RobH-WKGS/wireless-prop-trigger/docs/prop_rx_schematic.png

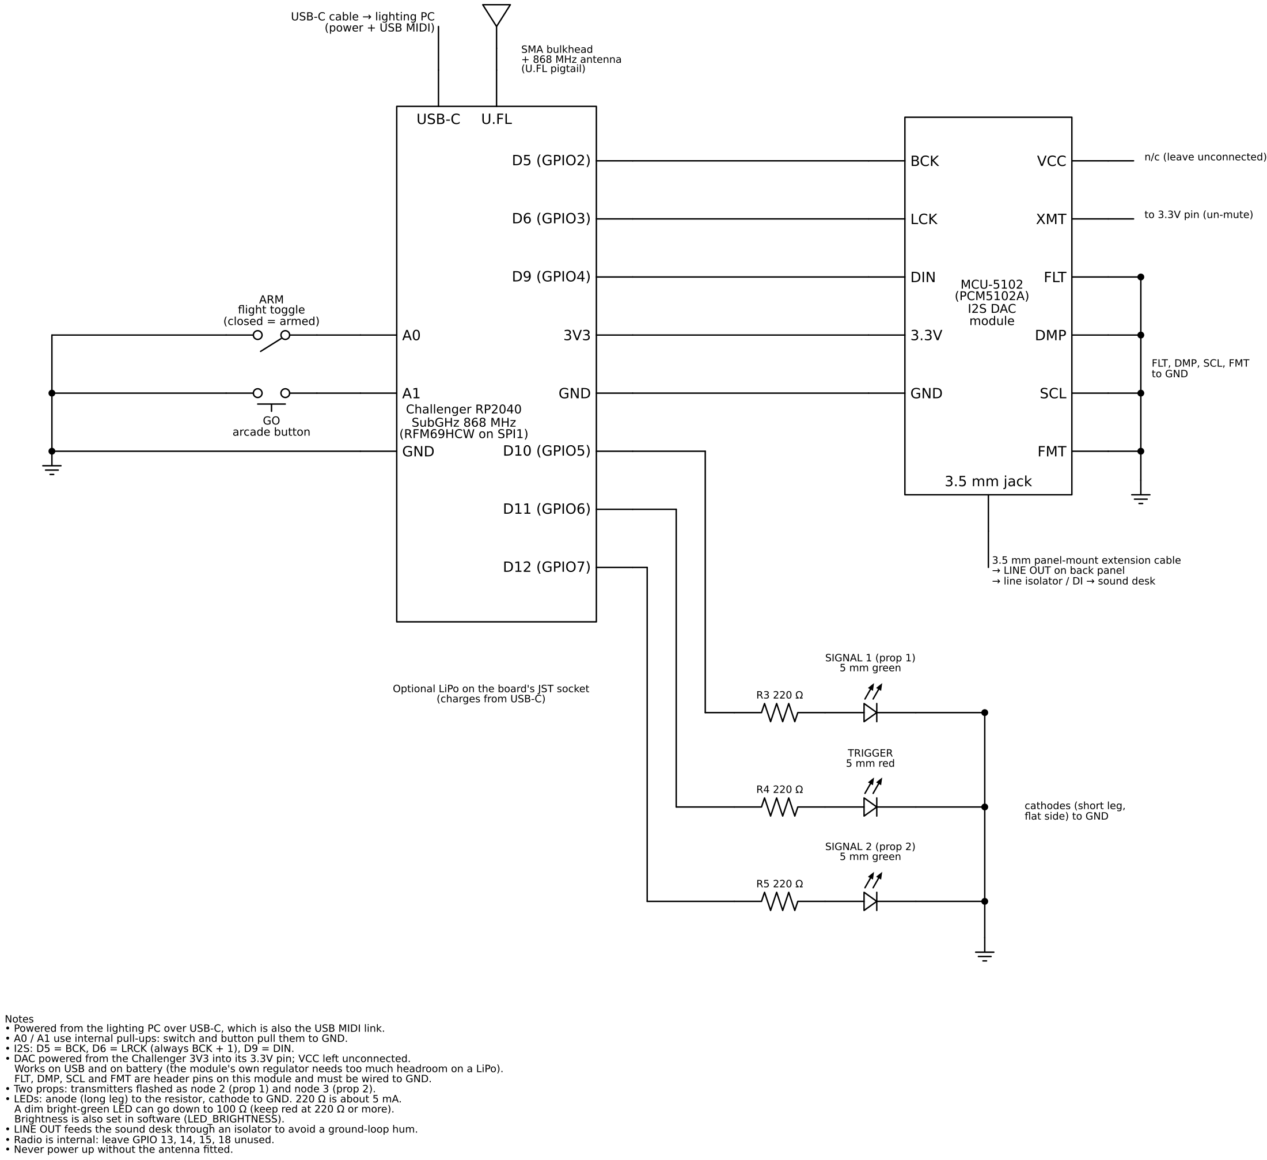
docs/prop_rx_schematic.png
