RobH-WKGS/wireless-prop-trigger/docs/prop_tx_schematic.png

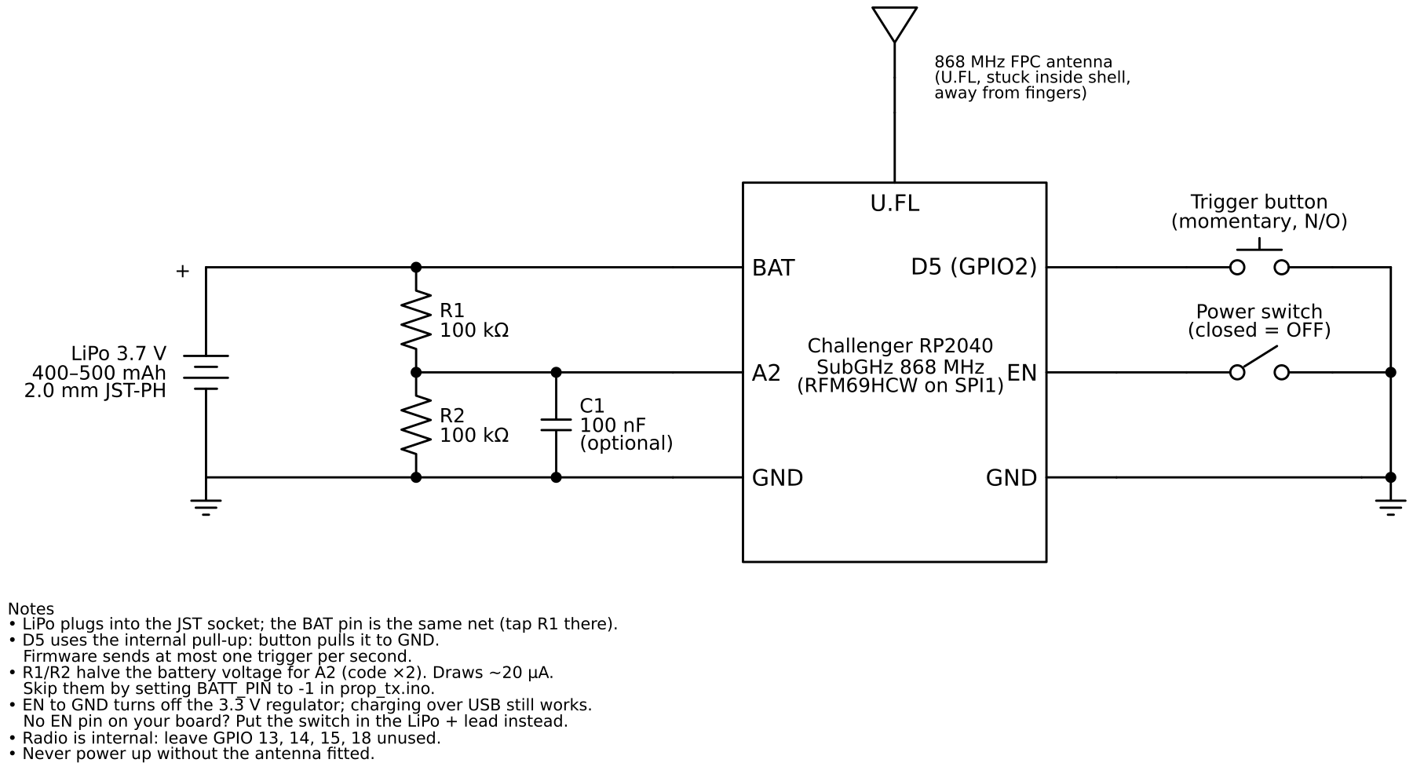
docs/prop_tx_schematic.png
