RobH-WKGS/wireless-prop-trigger/enclosure/3mf/receiver_lid.3mf

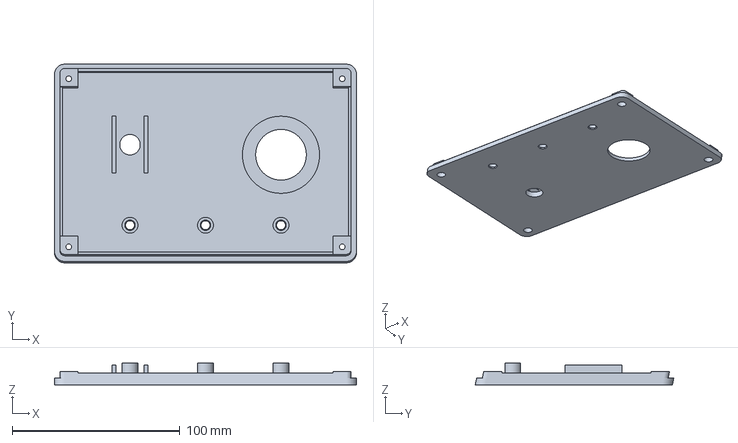
[picture p9: CAD file, 2026-11-09]
enclosure/3mf/receiver_lid.3mf
180.0 x 118.4 x 13.0 mm
