RobH-WKGS/wireless-prop-trigger/enclosure/stl/receiver_fit_panel.stl

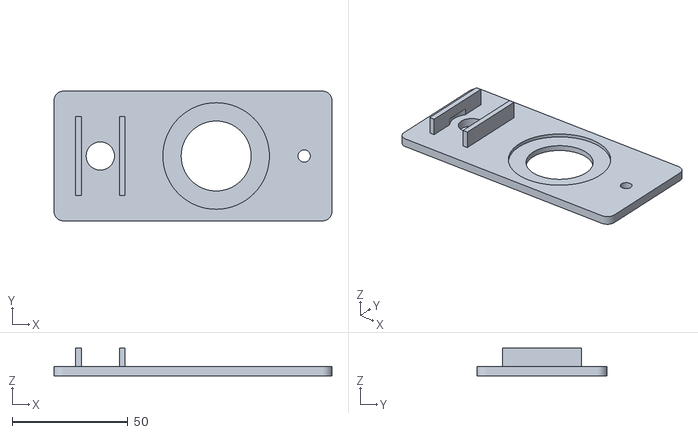
[picture p10: CAD file, 2026-11-09]
enclosure/stl/receiver_fit_panel.stl
120.0 x 56.0 x 12.0
