RobH-WKGS/wireless-prop-trigger/enclosure/3mf/receiver_base.3mf

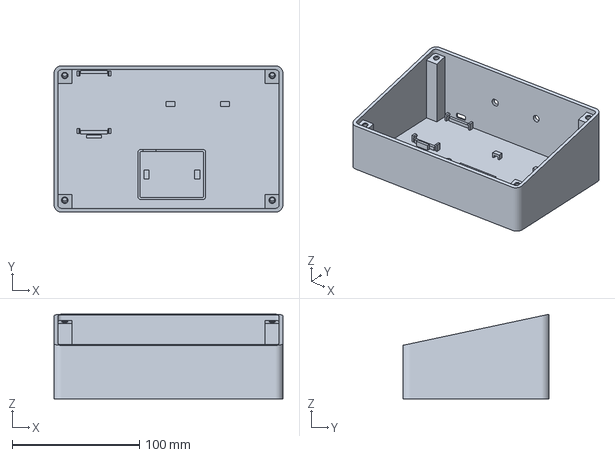
[picture p11: CAD file, 2026-11-06]
enclosure/3mf/receiver_base.3mf
180.0 x 115.0 x 66.4 mm
