RobH-WKGS/wireless-prop-trigger/enclosure/stl/receiver_lid_text.stl

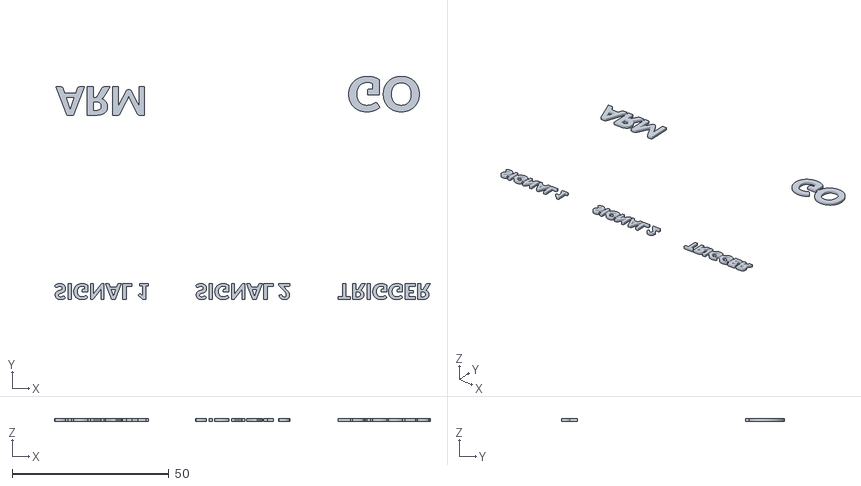
[picture p12: CAD file, 2026-11-09]
enclosure/stl/receiver_lid_text.stl
119.9 x 71.3 x 1.00
