RobH-WKGS/wireless-prop-trigger/enclosure/stl/receiver_base_text.stl

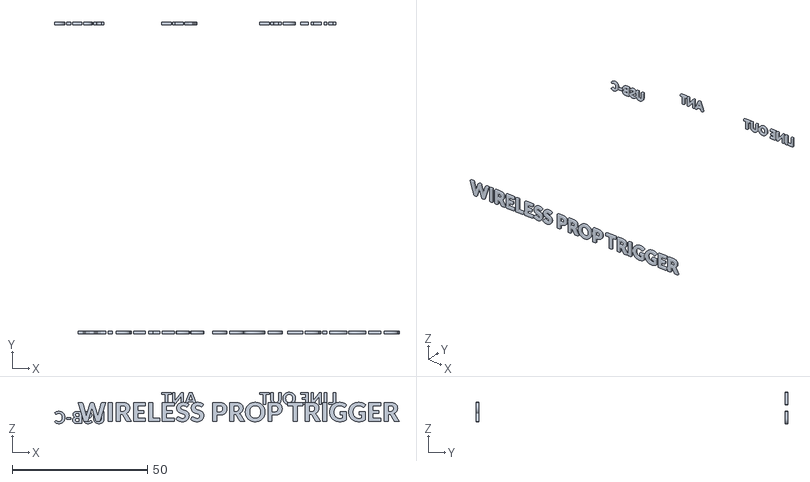
[picture p13: CAD file, 2026-10-31]
enclosure/stl/receiver_base_text.stl
127.3 x 115.0 x 11.7
