RobH-WKGS/wireless-prop-trigger/enclosure/stl/receiver_fit_cradle.stl

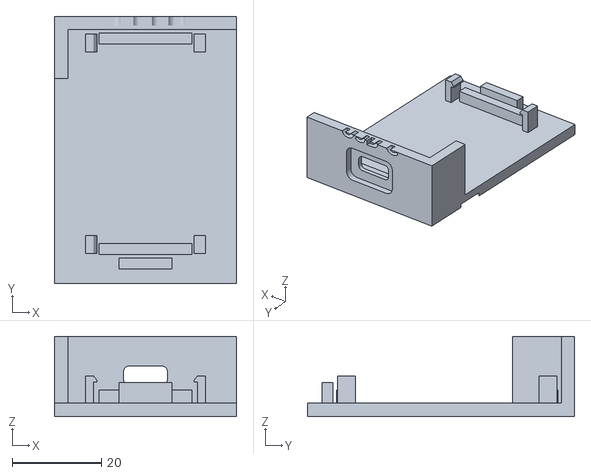
[picture p14: CAD file, 2026-10-31]
enclosure/stl/receiver_fit_cradle.stl
40.9 x 60.0 x 18.0
