RobH-WKGS/wireless-prop-trigger/(list of files, cad)

Other CAD files:
enclosure/stl/receiver_base.stl
enclosure/stl/receiver_lid.stl
