RobH-WKGS/wireless-prop-trigger/enclosure/images/lid_print_face.png

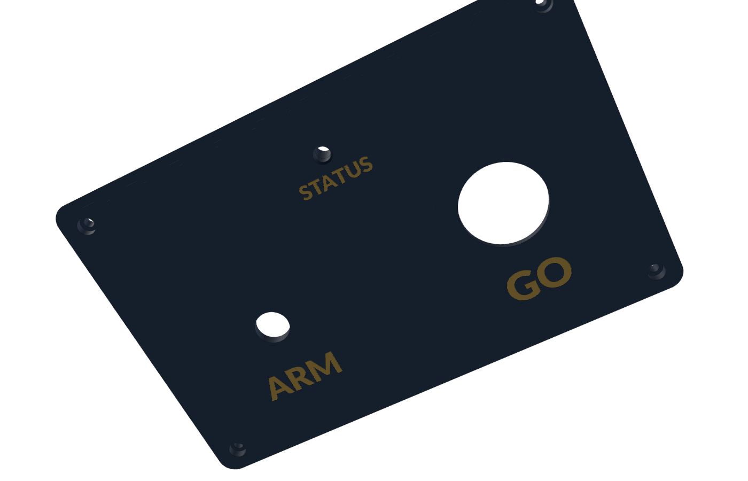
enclosure/images/lid_print_face.png
