RobH-WKGS/wireless-prop-trigger/(commit log)

2026-10-26 Wireless prop trigger: Challenger RP2040 SubGHz transmitter and receiver
    RFM69 868MHz prop button -> USB MIDI note for Avolites Titan plus
    synced WAV playback over I2S. Includes README with parts list,
    wiring, Titan setup and show-day checklist.
    Claude-Session: https://claude.ai/code/session_01HzwnzX2aJoiBGHMYVSww5y
2026-10-28 Add prop transmitter schematic (SVG/PNG + schemdraw source)
    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
2026-10-31 Add 3D-printable receiver case
    Parametric OpenSCAD desk console: base tray + control lid with flight
    switch (ARM), 30 mm arcade button (GO) and status LED. M3 SHCS into
    heat-set inserts, USB-C/SMA/line-out on the back panel, snap-in board
    cradle, DAC and LiPo mounts, fit-test coupons, print notes and
    previews. README parts list updated to match.
    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
    [receiver_base.stl, receiver_case.scad, receiver_fit_cradle.stl, receiver_fit_panel.stl, receiver_lid.stl]
2026-10-31 Receiver case: 12 degree sloped top and two-colour label inlays
    Top now slopes up to the back (front_h 42, top_angle 12); screws and
    controls sit square to the slope. Labels are separate inlay bodies
    (1.0 mm) that exactly fill their recesses. Adds ready-to-slice
    PrusaSlicer 3MFs (body extruder 1, text extruder 2, test-sliced),
    make_3mf.py, new previews, and README guidance for XL 2T vs MMU.
    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
    [receiver_base.3mf, receiver_base.stl, receiver_base_text.stl, receiver_case.scad, receiver_fit_cradle.stl, receiver_fit_panel.stl, receiver_lid.3mf, receiver_lid.stl]
2026-11-06 Add TRIGGER LED, flight-switch rotation stop, 1 s trigger limit
    Firmware: second 5 mm LED chained after the first; SIGNAL shows link
    state, TRIGGER lights for 1 s on every press (white = fired,
    magenta = pressed while disarmed). Prop lockout raised to 1 s and the
    receiver enforces a 1 s minimum gap per cue across prop and GO.
    Case: two LED holes/tubes with SIGNAL and TRIGGER labels, 16.4 mm
    pocket so the 16 mm flight-switch cover can't rotate; fit panel,
    STLs, 3MFs, previews and READMEs updated.
    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
    [receiver_base.3mf, receiver_base.stl, receiver_case.scad, receiver_fit_panel.stl, receiver_lid.3mf, receiver_lid.stl, receiver_lid_text.stl]
2026-11-06 Move flight switch rotation stop inside the lid
    Replace the top-face pocket with two rails under the lid that sit
    either side of the 16 x 29.4 mm switch body (16.4 mm gap, open-ended,
    20 mm relief for the inner bushing nut). The outside cover pocket is
    now optional and off by default, sized for a 17.85 x 40.8 mm cover
    with the hole 14.8 mm from the hinge end. ARM label placed clear of
    the cover. Fit panel, lid STLs/3MF, previews and README updated.
    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
    [receiver_case.scad, receiver_fit_panel.stl, receiver_lid.3mf, receiver_lid.stl, receiver_lid_text.stl]
2026-11-07 Add receiver schematic; note TX rate limit; power LEDs via 1N4148
    New docs/prop_rx_schematic (schemdraw source, SVG, PNG): Challenger,
    PCM5102A DAC and line-out jack, ARM/GO, chained SIGNAL/TRIGGER LEDs,
    USB-C and antenna. LEDs now fed from USB 5 V through a 1N4148 (~4.3 V)
    with a 330 ohm data resistor and 100 nF per LED, since 5 mm WS2812s
    are unreliable on 3.3 V. TX schematic notes the 1 s trigger limit.
    README wiring and parts list updated.
    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
2026-11-07 Receiver: plain red/green 5 mm LEDs instead of WS2812
    SIGNAL = green LED on D10, TRIGGER = red LED on D11, each through
    220 ohm, PWM-dimmed (LED_BRIGHTNESS). SIGNAL: off = no prop, solid =
    good link, slow blink = weak RSSI, fast blink = prop battery low.
    TRIGGER: solid 1 s = fired, flicker 1 s = pressed while disarmed.
    Lamp test at power-up. Drops the NeoPixel library and the 1N4148 /
    330 ohm / 100 nF parts. Receiver schematic, READMEs and case comments
    updated.
    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
    [receiver_case.scad]
2026-11-07 Receiver: switch DAC to MCU-5102 (CJMCU-5102) module
    The MCU-5102 has no SCK pad: SCL, FLT, DMP and FMT are header pins
    wired to GND, and XMT is tied to the module's own 3.3V output to
    un-mute. VCC now from USB 5 V (onboard regulator). Audio comes from
    the module's 3.5 mm jack via a panel-mount extension cable to the
    LINE OUT hole. Schematic, wiring table, parts lists and assembly
    steps updated; firmware unchanged.
    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
2026-11-07 Fix build on RP2040: bundle patched RFM69, move Cue struct
    RFM69.h defaults its CS pin to SS, which arduino-pico doesn't define
    for the Challenger 2040 SubGHz, and the library's .cpp files compile
    separately so a sketch-level define can't reach them. Bundle LowPowerLab
    RFM69 v1.6.0 (GPL-3, licence included) in each sketch's src/RFM69 with
    an SS fallback to GPIO9; drops the SPIFlash dependency too.
    Receiver: declare struct Cue before the IDE's auto-generated prototypes.
    Both sketches now compile on arduino-pico 6.3.2 (real Arduino ctags)
    with no errors or warnings. README library steps updated.
    Claude-Session: https://claude.ai/code/ses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
    [RFM69.h, prop_rx.ino, prop_tx.ino]
2026-11-07 Receiver: clear #error when the TinyUSB USB stack isn't selected
    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
    [prop_rx.ino]
2026-11-07 Receiver audio: power DAC from 3V3, add test tone and status
    The MCU-5102's VCC regulator needs USB 5 V, so the DAC was silent or
    under-powered on battery. Feed the Challenger's 3V3 into the module's
    3.3V pin and leave VCC unconnected. Firmware: I2S starts even with no
    WAV files; Serial 's' prints audio status, 't' plays a 2 s 1 kHz test
    tone (or hold GO at power-up). Schematic and README updated.
    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
2026-11-07 Receiver: list flash files in the audio status
    Makes 'data folder not uploaded' and 'wrongly named file' obvious from
    the Serial 's' command. README: cue files must be named cue1-4.wav.
    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
    [prop_rx.ino]
2026-11-09 Two props, per-prop SIGNAL LEDs, MIDI diagnostics
    Receiver: SIGNAL 1 (D10) and SIGNAL 2 (D12) show the link to prop 1
    (node 2) and prop 2 (node 3); TRIGGER (D11) unchanged and now
    double-blips when no USB host is connected. Every MIDI message in/out
    is logged with USB state; Serial commands h/m/n (help, MIDI status,
    test note for Titan Learn without audio or lockout). 2 s status line
    per prop. Lid: three LEDs aligned with ARM / centre / GO.
    Schematic, STLs/3MF, previews and READMEs (incl. MIDI troubleshooting)
    updated. Both sketches compile clean with all warnings.
    Claude-Session: https://claude.ai/code/session_01HzwnzX2aJoiBGHMYVSww5y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
    [receiver_case.scad, receiver_fit_panel.stl, receiver_lid.3mf, receiver_lid.stl, receiver_lid_text.stl]
2026-11-09 Receiver: ARM off now blocks GO and test commands too
    Disarmed = safe: GO presses only flicker TRIGGER and log 'GO ignored
    (DISARMED)'; Serial 'n' test note and 't' test tone, and the power-up
    GO tone, are refused unless armed. README updated.
    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
2026-11-09 Receiver: USB_MIDI_ONLY option for hosts that ignore composite devices
    Titan's USB Expert didn't list the receiver. Optional MIDI-only USB
    configuration (drops the CDC serial interface via clearConfiguration).
    README troubleshooting: restart ACW service, MIDI-only build, BOOT
    button for re-upload, Watch MIDI panel selection.
    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
    [prop_rx.ino]
2026-11-09 README: Titan reads USB MIDI via Windows, not USB Expert
    Per the Avolites manual, T3 supports USB-MIDI through Windows MIDI
    devices; USB Expert's Connected Panels only lists Avolites hardware.
    Troubleshooting now: MIDI-OX check, restart Titan after any re-plug or
    upload, Learn in the Triggers window; USB_MIDI_ONLY kept as last resort.
    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
