RobH-WKGS/wireless-prop-trigger/(notices)

Notices in the files:
prop_tx/src/RFM69/RFM69.h:
Copyright LowPowerLab LLC 2018, https://www.LowPowerLab.com/contact
Public License as published by the Free Software
http://www.gnu.org/licenses/gpl-3.0.txt
